Rinsent/Silomer/README.md

# Silomer
 Силомер на ардуинке

Old - Протестированный скетч без изменений

New - Новые и исправленные версии скетча
