Rinsent/Silomer/Разводка силомера дисплей амперка.png

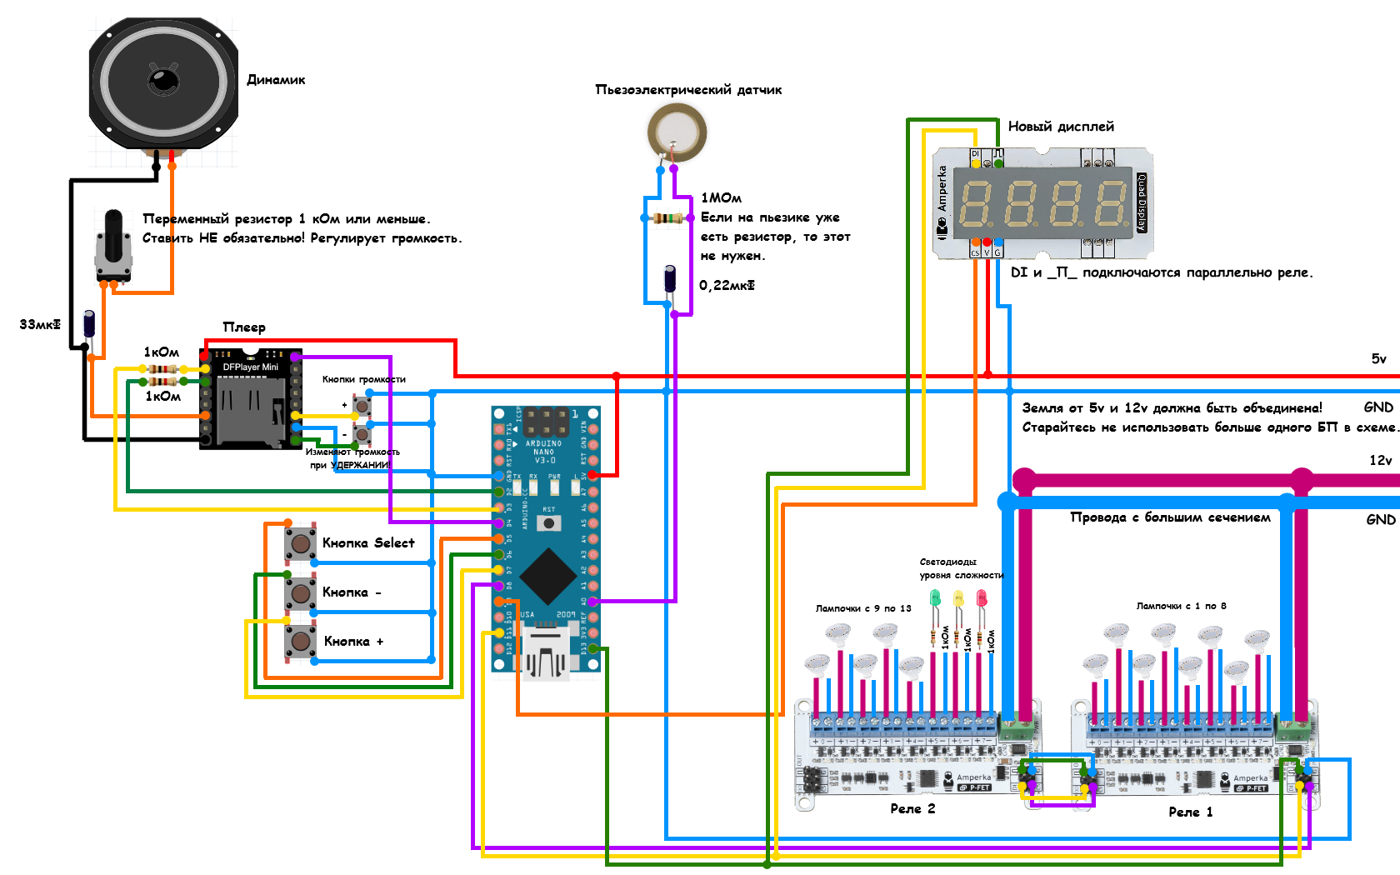
Разводка силомера дисплей амперка.png
