Rinsent/Silomer/Разводка силомера дисплей старый.png

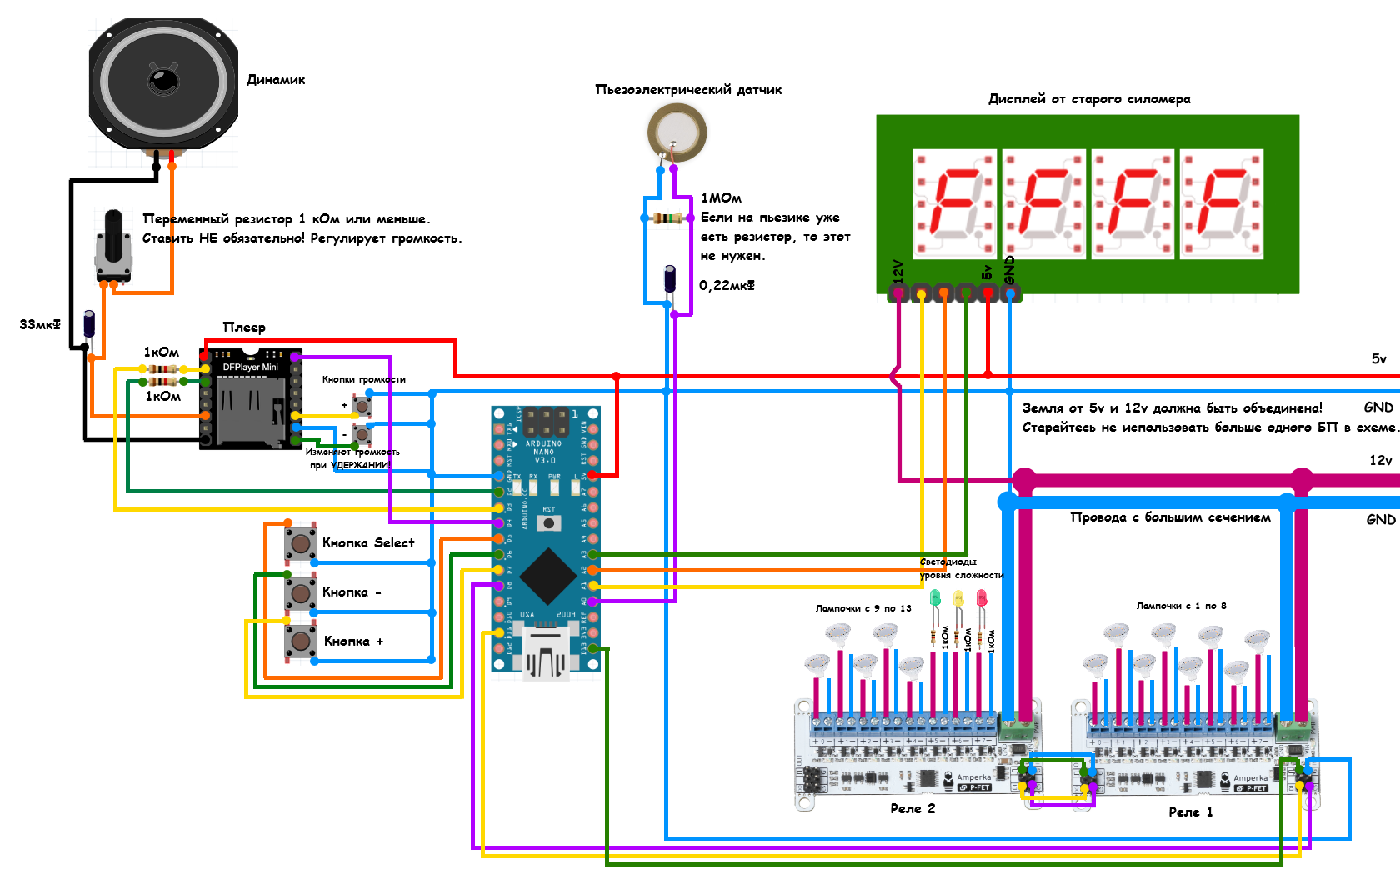
Разводка силомера дисплей старый.png
