Rinsent/Silomer/(commit log)

2019-09-01 Create Разводка силомера.png
2019-09-01 Create Разводка силомера дисплей амперка.png
2019-09-01 Create Разводка силомера дисплей старый.png
2019-09-10 Create График работы силомера.png
